minisystem/voice-card-socket/Voice Card Test Panel 10cmx15cm 1.1.dxf

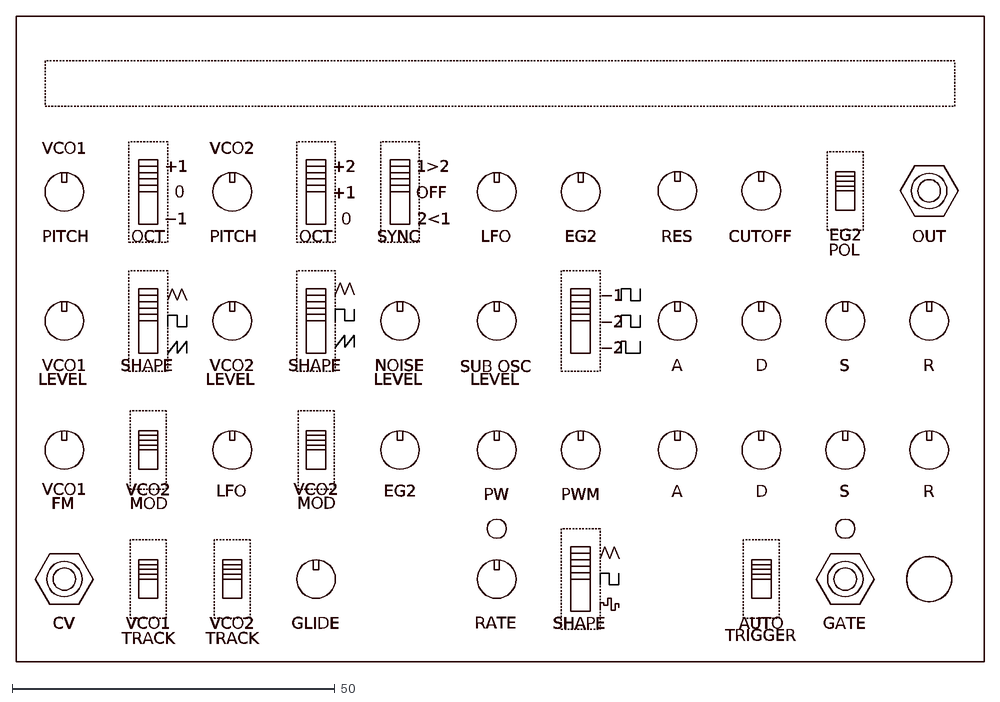
[picture p1: CAD file, 2015-12-05]
Voice Card Test Panel 10cmx15cm 1.1.dxf
A
D
S
R
PW
VCO1
FM
LEVEL
NOISE
GATE
RATE
PITCH
PWM
RES
CV
CUTOFF
LFO
EG2
OUT
GLIDE
VCO2
AUTO
TRIGGER
TRACK
OCT
SHAPE
0
SYNC
+1
+2
−1
2<1
OFF
1>2
MOD
POL
SUB OSC
−2
