minisystem/voice-card-socket/(list of files, cad)

Other CAD files:
Voice Card Test Panel 10cmx15cm 1.0.dxf
