minisystem/voice-card-socket/voice-socket-board.kicad_pcb

## KiCad design voice-socket-board.kicad_pcb (2016-03-29)

Schematic: voice-socket-board.sch, noname.sch

Parts:
C1, C2, C19, C54, C57, C59, C62: 10p; SM0603-C-JRL
C3, C4, C6, C7, C8, C9, C10, C11, C12, C13, C53, C55, C56, C63, C64: 0.1μ; SM0603-C-JRL
C5: 470n; SM0805-HAND
C14: 4.7μ; CAP-5MM-BOX-0805-COMBO
C15, C21: 1n; SM0603-C-JRL
C16, C23, C24, C25, C26, C29, C30, C33, C34, C35, C36, C58: 100n; SM0603-C-JRL
C17, C18: 10μ; 2MM-POL-CAP
C20: 0.01μ; SM0603-C-JRL
C22: 1μ; SM0603-C-JRL
C27, C28, C31, C32, C37, C38, C39, C40, C41, C42, C45, C46, C47, C48, C49, C50, C51, C52: 0.1µ; SM0603-C-JRL
C43, C44: 10μF; 2MM-POL-CAP
C60: 10µ; 2MM-POL-CAP
C61: 220n; SM0805-HAND
C65: 47p; SM0603-C-JRL
D1, D2: LM4040-3.0; SOT23-132-JRL
D3, D5, D6, D7, D8, D12: 1N4148; SOD323-JRL
D4, D9: LED; 3MM-LED-C1A2
D10, D11: D; SMB-1C2A
J1, J2, J3: JACK_MONO_SW; PJ-301B-JACK-SLOTS
P1, P2: CONN_01X03; Pin_Header_Straight_1x03
P3: CONN_02X05; Pin_Header_Straight_2x05
P4: DDR3-DIMM; DDR3-DIMM-240-FCI
Q1, Q7, Q8, Q9: MMBT3904; SOT23-132-JRL
Q2: DMMT3904W; SOT363-JRL
Q3, Q4: 2N7002; SOT363-JRL
Q6, Q10: MMBT3906; SOT23-132-JRL
R1, R2, R3, R4, R6, R7, R10, R11, R12, R13, R14, R56, R68, R76, R77, R85, R89, R90, R91, R92, R97, R98, R99, R100, R102, R109, R110, R111, R112, R127, R129: 100K; SM0603-R-JRL
R5, R15, R16, R78: 2.2meg; SM0603-R-JRL
R8, R17: 91K; SM0603-R-JRL
R9, R18, R28, R71: 1meg; SM0603-R-JRL
R19, R20, R21, R22, R32, R33, R34, R35, R36, R37, R38, R39, R40, R41, R42, R43, R44, R45, R46, R47, R65, R87, R88, R95, R96, R103, R104, R116, R117: 4.7K; SM0603-R-JRL
R23, R59: 20K; SM0603-R-JRL
R24, R25, R26, R27, R30, R54, R55, R57, R114, R115, R118, R119, R121, R122: 10K; SM0603-R-JRL
R29, R31, R50: 100; SM0603-R-JRL
R48, R94, R126: 150K; SM0603-R-JRL
R49: 330K; SM0603-R-JRL
R51, R58, R64, R66, R120, R123: 1K; SM0603-R-JRL
R52, R53, R60, R61, R62, R73, R82, R83, R93, R113, R125, R128: 47K; SM0603-R-JRL
R63: 680K; SM0603-R-JRL
R67, R86: 15K; SM0603-R-JRL
R69, R70: 470; SM0603-R-JRL
R72, R106, R108: 18K; SM0603-R-JRL
R74, R130: 120K; SM0603-R-JRL
R75: 2.7K; SM0603-R-JRL
R79, R80: 220K; SM0603-R-JRL
R81: 68K; SM0603-R-JRL
R84: 56K; SM0603-R-JRL
R101: 390K; SM0603-R-JRL
R105, R124: 27K; SM0603-R-JRL
R107: 680K**; SM0603-R-JRL
R131: 33K; SM0603-R-JRL
SW1, SW2, SW5, SW6, SW14: SPST; SS-12F45-1P2T-SLIDE
SW3, SW4, SW9, SW10, SW11, SW12, SW13, SW16: SP3T; SS-23E02-2P3T-SLIDE
SW7: Switch_SPDT_x2; SS-12F45-1P2T-SLIDE
SW8: 2P3T; SS-23E02-2P3T-SLIDE
SW15: TACT_SWITCH; SW_PUSH-12mm
TP1, TP2, TP3, TP4, TP5, TP6, TP7, TP8, TP9, TP10, TP11, TP12, TP13, TP14, TP15: CONN_1; TEST_POINT_LOOP_4592
TR1, TR2: 20K; Bourns_3362P
TR3, TR6, TR8, TR10: 100K; Bourns_3362P
TR4, TR7: 100K; Bourns-3296W
TR5, TR9: 20K; Bourns-3296W
U1: LM833; TSSOP8-JRL
U2, U3, U4, U5, U6, U9, U10, U12: TL072-; TSSOP8-JRL
U7: MAX9945; MSOP-8_3x3mm_Pitch0.65mm
U8: CD4013; TSSOP-14_4.4x5mm_Pitch0.65mm
U11: NE5534; SOIC-8_3.9x4.9mm_Pitch1.27mm
VR1, VR2, VR3, VR4, VR5, VR7, VR8, VR9, VR10, VR11, VR12, VR13, VR14, VR16, VR17, VR18, VR19, VR20, VR21, VR22, VR23, VR24, VR25: 50K; RV09AF-40-ALPHA-POT
VR6: 1meg LOG; RV09AF-40-ALPHA-POT
VR15: 100K; RV09AF-40-ALPHA-POT

Connections:
+12V: C23.1, C25.1, C27.1, C29.1, C31.1, C33.1, C35.1, C37.1, C39.1, C41.1, C43.1 (+), C45.1, C47.1, C49.1, C51.1, C63.1, D10.1 (K), P3.9, P3.10, P4.6, P4.12, P4.26, P4.37, P4.52, P4.72, P4.88, P4.97, P4.117, P4.126, P4.132, P4.146, P4.157, P4.172, P4.192, P4.208, P4.217, P4.237, Q1.3 (C), Q9.3 (C), R21.1, R32.1, R34.1, R36.1, R38.1, R40.1, R42.1, R44.1, R46.1, R56.2, R63.2, R65.2, R74.2, R80.2, R81.2, R95.1, R103.1, R116.2, R117.2, SW15.1, TR3.1, TR6.3, TR8.3, TR10.1, U1.8 (V+), U2.8 (V+), U3.8 (V+), U4.8 (V+), U5.8 (V+), U6.8 (V+), U7.7 (V+), U8.14 (VDD), U9.8 (V+), U10.8 (V+), U11.7 (V+), U12.8 (V+), VR1.3, VR2.3
-12V: C24.2, C26.2, C28.2, C30.2, C32.2, C34.2, C36.2, C38.2, C40.2, C42.2, C44.2 (-), C46.2, C48.2, C50.2, C52.2, C64.2, D11.2 (A), P3.1, P3.2, P4.7, P4.18, P4.29, P4.43, P4.49, P4.64, P4.76, P4.101, P4.127, P4.138, P4.149, P4.163, P4.169, P4.184, P4.196, P4.221, R20.2, R84.1, R87.1, R101.2, R130.2, TR3.3, TR4.3, TR7.3, TR10.3, U1.4 (V-), U2.4 (V-), U3.4 (V-), U4.4 (V-), U5.4 (V-), U6.4 (V-), U7.4 (V-), U9.4 (V-), U10.4 (V-), U11.4 (V-), U12.4 (V-), VR1.1, VR2.1
EG1_ATTACK_CV: P4.83, P4.203, VR7.2
EG1_DECAY_CV: P4.89, P4.209, VR9.2
EG1_ENV_OUT: P4.93, P4.213, R124.2, TP10.1
EG1_GATE: C61.1, D8.2 (K), P4.99, P4.120, P4.219, P4.240, Q8.2 (E), R118.2, R119.1, SW14.2
EG1_INV_OUT: P4.90, P4.210
EG1_RELEASE_CV: P4.92, P4.212, VR13.2
EG1_SUSTAIN_CV: P4.96, P4.216, VR11.2
EG2_ATTACK_CV: P4.106, P4.226, VR8.2
EG2_DECAY_CV: P4.112, P4.232, VR10.2
EG2_ENV_MOD: R1.2, SW2.1, VR5.2
EG2_ENV_OUT: P4.116, P4.236, SW7.3 (C)
EG2_INV_OUT: P4.113, P4.233, SW7.1 (A)
EG2_OUT: SW7.2 (B), TP6.1, VR5.3, VR17.3
EG2_RELEASE_CV: P4.115, P4.235, VR14.2
EG2_SUSTAIN_CV: P4.119, P4.239, VR12.2
KEY_TRACK: R31.1, R93.2, R94.1, SW5.1, SW6.1, TP1.1
LFO_GATE: C15.1, R49.1, R54.1, R114.1, U3.1, VR15.3
LFO_MOD: R2.2, SW1.1, VR3.2
LFO_OUT: R85.2, SW9.3, TP12.1, VR3.3, VR18.3
LFO_PULSE: P2.2, SW9.2
LFO_TRI: P1.2, SW9.1
MASTER_TUNE: R5.2, R15.2, VR1.2
NOISE: C19.2, R68.1, R69.2, TP2.1, U6.1, VR23.3
unnamed: C3.1, R19.2, R20.1
unnamed: C4.1, R21.2, R22.1
unnamed: C5.1, R30.2, VR6.2, VR6.3
unnamed: C6.1, R32.2, R33.1
unnamed: C7.1, R34.2, R35.1
unnamed: C8.1, R36.2, R37.1
unnamed: C9.1, R38.2, R39.1
unnamed: C10.1, R40.2, R41.1
unnamed: C11.1, R42.2, R43.1
unnamed: C12.1, R44.2, R45.1
unnamed: C13.1, R46.2, R47.1
unnamed: C14.1, R51.1, U3.6 (-)
unnamed: C14.2, P1.3, R48.1, R52.1, U3.7
unnamed: C15.2, R58.1
unnamed: C16.2, Q2.5 (E), R63.1
unnamed: C17.1 (+), Q2.4 (E), R66.1
unnamed: C18.1 (+), Q2.3 (C), R65.1
unnamed: C18.2 (-), R67.2
unnamed: C19.1, R67.1, R68.2, U6.2 (-)
unnamed: C20.1, Q4.3 (D), U7.2 (-)
unnamed: C20.2, R70.1, R73.2, U7.6
unnamed: C21.1, R73.1, R76.2, U6.6 (-)
unnamed: C22.2, R77.2
unnamed: C53.1, R87.2, R88.1
unnamed: C54.1, R90.1, R91.1, R92.2, U9.6 (-)
unnamed: C55.1, R95.2, R96.1
unnamed: C56.1, R103.2, R104.1
unnamed: C57.1, R97.1, R98.1, R99.1, R100.1, R101.1, R102.2, R127.1, U10.6 (-)
unnamed: C57.2, R102.1, TP4.1, TR2.1, TR2.2, U10.7
unnamed: C58.1, R106.1, R108.2
unnamed: C59.1, C60.1 (+), R113.2, TP5.1, U10.1
unnamed: C59.2, R109.2, R110.2, R111.2, R112.2, R113.1, U10.2 (-)
unnamed: C62.1, R121.1, R122.2, U11.2 (-)
unnamed: C62.2, R122.1, R123.2, U11.6
unnamed: C65.1, R79.1, R80.1, U12.2 (-)
unnamed: C65.2, D12.1 (A), U12.1
unnamed: D1.2 (A), R19.1, R23.2
unnamed: D2.1 (K), R22.2, R24.1
unnamed: D3.2 (K), R58.2, R59.1, U5.3 (+)
unnamed: D4.2 (A), R64.2
unnamed: D5.1 (A), Q3.2 (G), Q3.5 (G), U5.1
unnamed: D5.2 (K), Q4.2 (G), Q4.5 (G), R72.2
unnamed: D6.1 (A), R82.2, SW10.2
unnamed: D6.2 (K), D7.2 (K), SW10.4
unnamed: D7.1 (A), R83.2, SW10.1
unnamed: D9.2 (A), R120.2
unnamed: D12.2 (K), R81.1, U8.3 (Cp)
unnamed: J1.3, R28.1, U2.5 (+)
unnamed: J2.3, R123.1
unnamed: J3.3, R115.1
unnamed: P1.1, U5.6 (-), U5.7
unnamed: P2.1, U4.1, U4.2 (-)
unnamed: P2.3, R60.1, U4.7
unnamed: Q1.1 (B), R62.1
unnamed: Q1.2 (E), R64.1
unnamed: Q2.1 (B), Q2.2 (B)
unnamed: Q3.1 (S), Q3.4 (S)
unnamed: Q3.3 (D), Q4.6 (D), R71.1
unnamed: Q3.6 (D), R69.1, R70.2
unnamed: Q4.1 (S), Q4.4 (S)
unnamed: Q6.2 (E), R105.1
unnamed: Q7.1 (B), R114.2
unnamed: Q7.2 (E), SW14.1
unnamed: Q7.3 (C), R116.1
unnamed: Q8.1 (B), R115.2
unnamed: Q8.3 (C), R117.1
unnamed: Q9.1 (B), R119.2
unnamed: Q9.2 (E), R120.1
unnamed: Q10.2 (E), R124.1
unnamed: R3.2, TR4.2
unnamed: R6.2, VR4.2
unnamed: R8.2, TR5.3
unnamed: R9.2, TR6.2
unnamed: R10.2, SW1.2
unnamed: R11.2, SW2.2
unnamed: R13.2, TR7.2
unnamed: R17.2, TR9.3
unnamed: R18.2, TR8.2
unnamed: R23.1, R27.2, SW3.1
unnamed: R24.2, R25.1, SW4.4
unnamed: R25.2, R26.1, SW3.4, SW4.2
unnamed: R29.1, VR6.1
unnamed: R29.2, U2.6 (-), U2.7
unnamed: R30.1, U2.3 (+)
unnamed: R31.2, U2.1, U2.2 (-)
unnamed: R33.2, VR7.3
unnamed: R35.2, VR8.3
unnamed: R37.2, VR9.3
unnamed: R39.2, VR10.3
unnamed: R41.2, VR11.3
unnamed: R43.2, VR12.3
unnamed: R45.2, VR13.3
unnamed: R47.2, VR14.3
unnamed: R48.2, R49.2, U3.3 (+)
unnamed: R50.2, VR15.1
unnamed: R51.2, VR15.2
unnamed: R52.2, R53.1, U5.5 (+)
unnamed: R54.2, R55.2, U4.5 (+)
unnamed: R56.1, R57.1, U5.2 (-)
unnamed: R60.2, R61.1, U4.3 (+)
unnamed: R62.2, U4.6 (-)
unnamed: R74.1, R75.2, U6.5 (+)
unnamed: R78.1, TR10.2
unnamed: R82.1, U8.13 (Q)
unnamed: R83.1, U8.1 (Q), U8.11 (Cp)
unnamed: R84.2, R86.2, U9.3 (+)
unnamed: R85.1, R89.2, U9.2 (-)
unnamed: R88.2, VR20.3
unnamed: R89.1, U9.1, VR21.3
unnamed: R90.2, VR21.2
unnamed: R91.2, VR20.2
unnamed: R93.1, SW11.4
unnamed: R94.2, SW11.2
unnamed: R96.2, VR16.3
unnamed: R97.2, VR16.2
unnamed: R98.2, SW11.3
unnamed: R99.2, VR18.2
unnamed: R100.2, VR17.2
unnamed: R104.2, VR19.3
unnamed: R105.2, TR1.3
unnamed: R106.2, TR2.3
unnamed: R107.2, TR3.2
unnamed: R109.1, VR25.2
unnamed: R110.1, VR22.2
unnamed: R111.1, VR23.2
unnamed: R112.1, VR24.2
unnamed: R118.1, SW15.2
unnamed: R125.1, SW16.4
unnamed: R126.2, SW16.2
unnamed: R127.2, SW16.3
unnamed: R128.1, R130.1, U12.5 (+)
unnamed: R128.2, SW10.3
unnamed: R129.2, R131.1, U12.6 (-)
unnamed: SW3.3, U1.5 (+)
unnamed: SW4.3, U1.3 (+)
unnamed: SW12.3, TP7.1, VR22.3
unnamed: SW13.3, TP9.1, VR25.3
unnamed: TR1.1, TR1.2, VR19.2
unnamed: U8.2 (~Q), U8.5 (D)
unnamed: U8.9 (D), U8.12 (~Q)
RANDOM: C21.2, R76.1, SW9.4, TP13.1, U6.7
RES_CTRL: P4.73, P4.193, Q6.3 (C)
SUB_OSC: R131.2, TP8.1, U12.7, VR24.3
VCA_CTRL: P4.74, P4.194, Q10.3 (C)
VCA_IN: P4.69, P4.189, R77.1, R78.2
VCA_OUT: P4.65, P4.185, R121.2
VCF_CTRL: P4.77, P4.197, R107.1, R108.1
VCF_IN: C60.2 (-), P4.48, P4.168
VCF_OUT: C22.1, P4.58, P4.178, TP11.1
VCO1_GLIDE_CV: R4.2, SW6.2
VCO1_OCTAVE: R7.2, U1.6 (-), U1.7
VCO1_PITCH_CV: C1.2, P4.20, P4.140, R1.1, R2.1, R3.1, R4.1, R5.1, R6.1, R7.1, TR5.1, TR5.2
VCO1_PULSE: P4.4, P4.124, SW8.8, SW13.2
VCO1_PWM_CV: C54.2, P4.3, P4.27, P4.123, P4.147, R92.1, TP3.1, U9.7
VCO1_SAW: P4.2, P4.122, R125.2, R126.1, SW13.1
VCO1_SCALE: C1.1, P4.15, P4.135, R8.1
VCO1_SYNC_IN: P4.21, P4.141, SW8.3
VCO1_TRI: P4.9, P4.129, SW13.4
VCO1_TRI_SHAPE: P4.1, P4.121, R9.1
VCO2_GLIDE_CV: R14.2, SW5.2
VCO2_OCTAVE: R12.2, U1.1, U1.2 (-)
VCO2_PITCH_CV: C2.2, P4.45, P4.165, R10.1, R11.1, R12.1, R13.1, R14.1, R15.1, R16.1, TR9.1, TR9.2
VCO2_PULSE: P4.25, P4.145, SW8.1, SW12.2, U12.3 (+)
VCO2_SAW: P4.24, P4.144, SW12.1, VR4.3
VCO2_SCALE: C2.1, P4.40, P4.160, R17.1
VCO2_SYNC_IN: P4.46, P4.166, SW8.4
VCO2_TRI: P4.34, P4.154, SW12.4
VCO2_TRI_SHAPE: P4.23, P4.143, R18.1
VCO2_TUNE: R16.2, VR2.2

Notes on the sheet:
VCF CTRL offset
(+4V to -6V)
**may need to lower to 510K or 560K USING 680K NOW SEEMS OK for 12V PWR
VCF CTRL input modified from Juno 106 VCF input for 0-10V response
OP AMP DECOUPLING
MIXER
CUTOFF
GLIDE
PULSE WIDTH
PWM
LFO_RATE
10 VPP
NEED TO CALCULATE VALUE OF Rs
+2.00V
+1.00V
0.00V
-1.00V
INIT CV
SCALE TRIM
TRI SHAPE
EG2 MOD
LFO MOD
RES
VCO2 MOD
VCA OFFSET
AUDIO OUT
ATTACK
DECAY
SUSTAIN
RELEASE
GATE
AUTO TRIGGER
GATE BUFFERS BREAD BOARDED
***
***Adjustments to get 10 VPP TRI and 0.1 to 100 Hz range
http://www.eeweb.com/blog/extreme_circuits/simple-white-noise-generator
This offsets the 200 mV FET pedestal voltage
QUICK & DIRTY DEBOUNCE
SYNC SWITCH
EG2 POL
Ian Fritz Super Sampe & Hold
NEED TO BREADBOARD SUB OSCILLATOR IT WILL HAVE +5V DC OFFSET. WILL THIS BE BLOCKED BY POST MIXER BLOCKING CAP? SEEMS OK - LOOKED AT OUTPUT OF MC-202 SUB-OSCILLATOR AND IT IS IDENTICAL TO BREADBOARDED SUB-OSCILLATOR
SH101 SUB OSCILLATOR FROM: http://electro-music.com/forum/topic-18983.html
OR SOME OTHER LOW OFFSET PRECISION OP AMP
VCF KEY TRACKING
PITCH CV
SIMPLE SLEW FROM: http://4.bp.blogspot.com/_UZMTRL9r8vU/TTGv3KWKT1I/AAAAAAAAAGw/SQU2PrACBgo/s1600/slew.jpg http://synovatron.blogspot.co.uk/p/cv-tools-project.html
VCO1 TRACK
VCO2 TRACK
WIDE
NORM
JUMPER
DECOUPLING
2_OCT_DOWN_SQUARE
2_OCT_DOWN_PULSE
1_OCT_DOWN_SQUARE
SOT23 PINS CONFIRMED
VCO PITCH SUMMING
FULL
HALF
TESTED BY BREADBOARD
VCF FM
ADJUST FOR DESIRED EFFECT
CLOCK GENERATOR FOR CD4013. THIS WAS TRICKY ON BREADBOARD WORKS WITH PULSE BUT NOT TRI.
LEVEL SHIFTER
NO JUNCTION HERE WILL NEED TO BRIDGE U4 PINS 6 + 7 ON PCB
R81 needs to be connected to -12V, NOT +12V. Still needs to be corrected!
On breadboard R79 is 10K - corrected on prototype, needs to be corrected here and in netlist

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
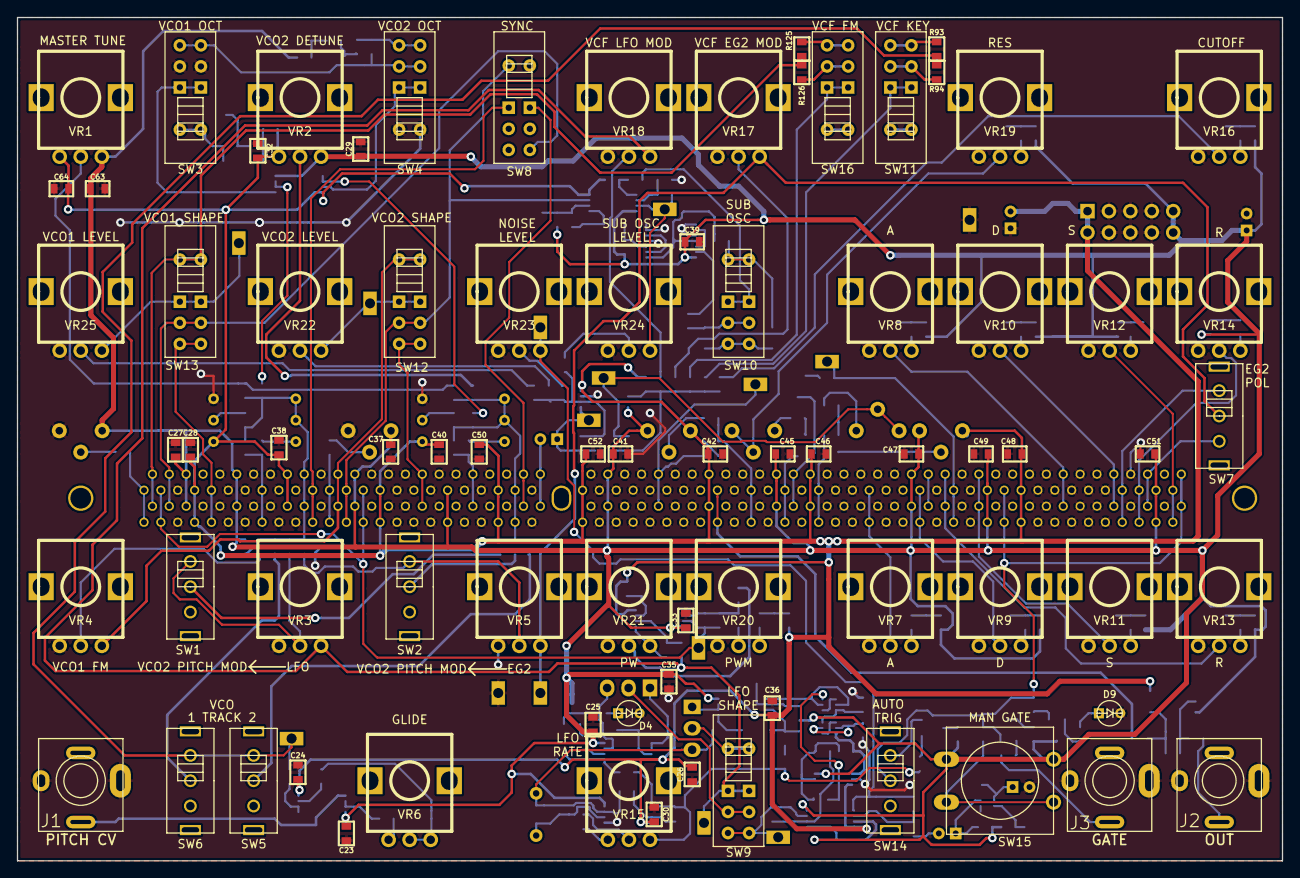
[picture p2: board voice-socket-board.kicad_pcb from above]

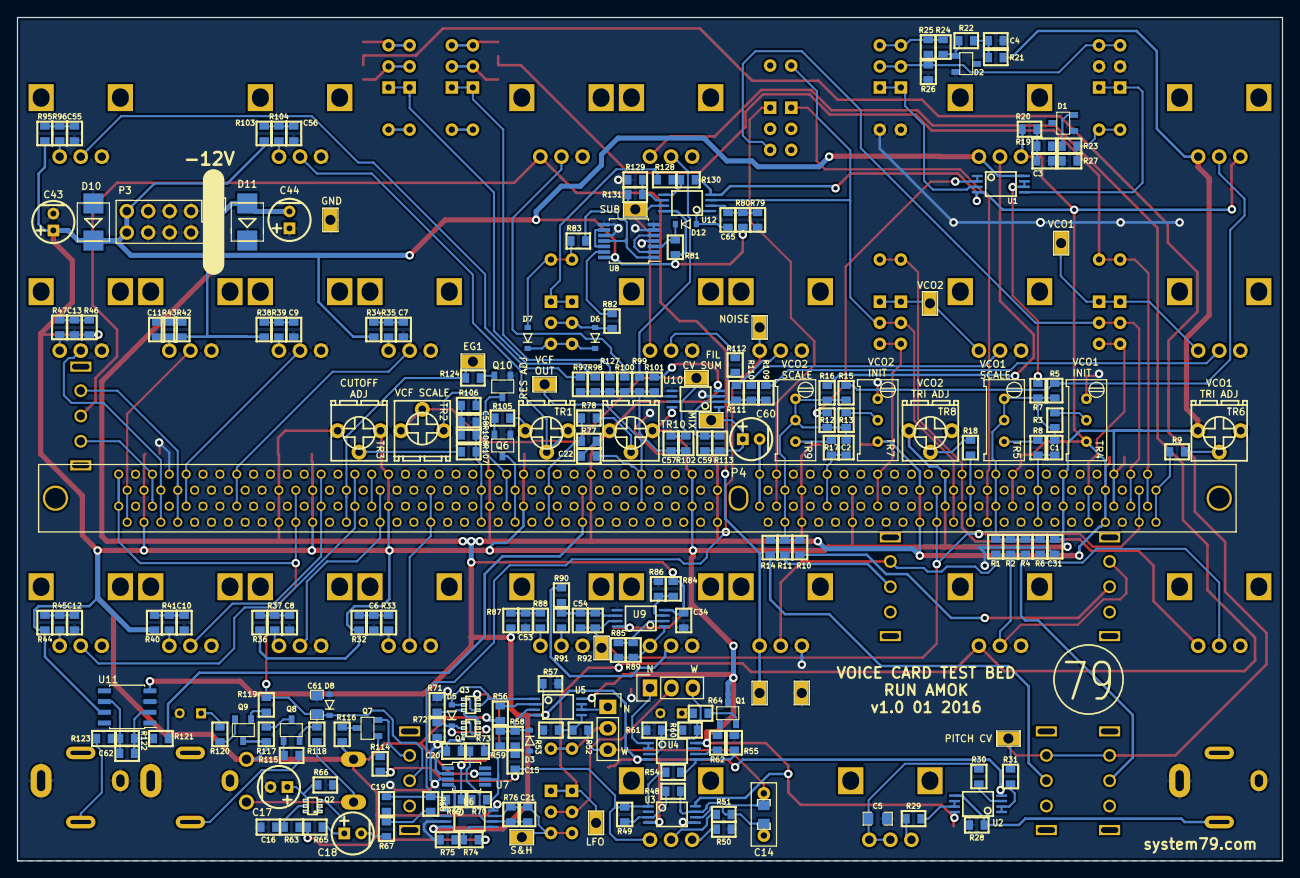
[picture p3: board voice-socket-board.kicad_pcb from below]

Board: 2 copper layers, 150.0 x 100.0 mm, 302 parts (224 on the bottom side), 195 nets.
