minisystem/voice-card-socket/(commit log)

2015-12-01 working on octave switching reference
    [voice-socket-board.sch]
2015-12-01 designing designing desiging. VCO1 pitch CV summing done
    [voice-socket-board.sch]
2015-12-02 adding features
    [voice-socket-board.sch]
2015-12-03 adding sub oscillator, for heavan's sake
    [Voice Card Test Panel 10cmx15cm 1.0.dxf, voice-socket-board.sch]
2015-12-03 added NPN buffer to external gate input
    [voice-socket-board.sch]
2015-12-04 confirmed gate buffers by bread boarding. Added gate LED circuit
    [voice-socket-board.sch]
2015-12-05 changed noise source to an eeweb simple white noise generator. breadboarded EDN zener noise source and couldn't get it to work
    [Voice Card Test Panel 10cmx15cm 1.1.dxf, voice-socket-board.sch]
2015-12-06 breadboarded noise, LFO and S&H. Changes based on testing added to schematic
    [voice-socket-board.sch]
2015-12-09 updated with new voice card pinout, sub oscillator added. Need to add LFO LED circuit
    [voice-socket-board.sch]
2015-12-09 added a few notes, plus LFO LED circuit
    [voice-socket-board.sch]
2015-12-09 just made DDR3 DIMM connector footprint. 240 pins. Phew.
    [voice-socket-board.sch]
2015-12-10 annotated, doing ERC now
    [voice-socket-board.sch]
2015-12-11 starting footprint assignment. added .gitingore
    [voice-socket-board.sch]
2015-12-11 almost done assigning footprints. Need to pay close attention to 3mm LEDs and 1N4148 SOD323 diode packages as the anode and cathodes were swapped in the more recent versions of Kicad
    [voice-socket-board.sch]
2015-12-11 footprints assigned. about to start PCB
    [voice-socket-board.sch]
2015-12-11 laid out grid on PCB for control placement,imported footprint modules
2015-12-11 switches, pots and jacks placed. about to move DIMM connector to center of board and see if that works
    [voice-socket-board.kicad_pcb]
2015-12-12 placed trimmers
    [voice-socket-board.kicad_pcb, voice-socket-board.sch]
2015-12-12 placing components
    [voice-socket-board.kicad_pcb, voice-socket-board.sch]
2015-12-12 placing components. placed PWM components
    [voice-socket-board.kicad_pcb, voice-socket-board.sch]
2015-12-13 placing components for LFO
    [voice-socket-board.kicad_pcb, voice-socket-board.sch]
2015-12-13 all components but decoupling caps placed. Started routing
    [voice-socket-board.kicad_pcb, voice-socket-board.sch]
2015-12-13 routing. 3D viewer is crashing. Trying to remove 3D model associations to see if there are any of my models that are causing the crash
    [voice-socket-board.kicad_pcb]
2015-12-13 routing. bit of a nightmare. need to figure out final position of power connector
    [voice-socket-board.kicad_pcb]
2015-12-13 routing. tedious
    [voice-socket-board.kicad_pcb]
2015-12-14 routing. added VCA CTRL from EG1. duh. forgot it in schematic
    [voice-socket-board.kicad_pcb, voice-socket-board.sch]
2015-12-14 more routing. need to rearrange power connector, main rail filter caps and protection diodes
    [voice-socket-board.kicad_pcb]
2015-12-15 routing. moved power connector
    [voice-socket-board.kicad_pcb]
2015-12-16 changed around LFO jumpers to reduce via count by one
    [voice-socket-board.kicad_pcb]
2015-12-16 added top and bottom ground planes
    [voice-socket-board.kicad_pcb]
2015-12-16 all non power and gnd traces routed
    [voice-socket-board.kicad_pcb, voice-socket-board.sch]
2015-12-17 power routed. now placing and routing decoupling caps
    [voice-socket-board.kicad_pcb]
2015-12-17 placing and routing decoupling caps
    [voice-socket-board.kicad_pcb]
2015-12-18 updating 3D models in library. Kicad 4.0 doesn't seem to like VRML1.0 format 3D models
    [voice-socket-board.kicad_pcb]
2015-12-18 more updating 3D models. About to move ENV2 polarity switch to make more room for cutoff knob
    [voice-socket-board.kicad_pcb]
2015-12-19 more 3D model updating for modules
    [voice-socket-board.kicad_pcb]
2015-12-19 all footprints have proper 3D models associated with them in VRML2.0 format. Still need models for test points
    [voice-socket-board.kicad_pcb]
2015-12-19 routed. maybe need more decoupling caps
    [voice-socket-board.kicad_pcb]
2015-12-19 tweaking routing for better ground plane coverage
    [voice-socket-board.kicad_pcb]
2015-12-21 added more test points
    [voice-socket-board.kicad_pcb, voice-socket-board.sch]
2015-12-21 changing out all SOT23 footprints for SOT23-132 - pin numbering was previously inconsistent and incoorect for LM4040 and MMBT3904 symbols and footprints
    [voice-socket-board.sch]
2015-12-21 traces to all SOT23 components deleleted. commit before loading in updated netlist
    [voice-socket-board.kicad_pcb]
2015-12-21 SOT23 footprints updated. double check MMBT3906
    [voice-socket-board.kicad_pcb, voice-socket-board.sch]
2015-12-23 adjust silkscreen references. about to add filter freq mod switch
    [voice-socket-board.kicad_pcb, voice-socket-board.sch]
2015-12-24 added filter FM switch
    [voice-socket-board.kicad_pcb, voice-socket-board.sch]
2015-12-24 changed FM and key tracking inputs into filter cutoff summer
    [voice-socket-board.kicad_pcb, voice-socket-board.sch]
2015-12-28 bit of ground plane adjustmemnt. last commit before changing sub oscillator circuit
    [voice-socket-board.kicad_pcb]
2015-12-28 changed CD4013 suboscillator clock input and added levelshiefter on sub osc output
    [voice-socket-board.kicad_pcb, voice-socket-board.sch]
2015-12-31 silkscreen editing
    [voice-socket-board.kicad_pcb]
2016-01-23 bit of track clean up and silk screen finalization. Printed for footprint check
    [voice-socket-board.kicad_pcb]
2016-01-24 more silkscreen labelling, almost ready to plot gerbers
    [voice-socket-board.kicad_pcb, voice-socket-board.sch]
2016-01-24 ordered from Seeed Fusion January 24
    [voice-socket-board.kicad_pcb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]
2016-03-29 fixed a board level error where sub oscillator intermediate clock was shorted to sub oscillator output test pin. added a couple of notes in schematic for corrections that still need to be made
    [voice-socket-board.kicad_pcb, voice-socket-board.sch]
